mas-ka/everGPIB/docs/everGPIB_NanoV3Ethernetシールド_パターンカット説明図.pdf

A | B | C | D | E | F | G

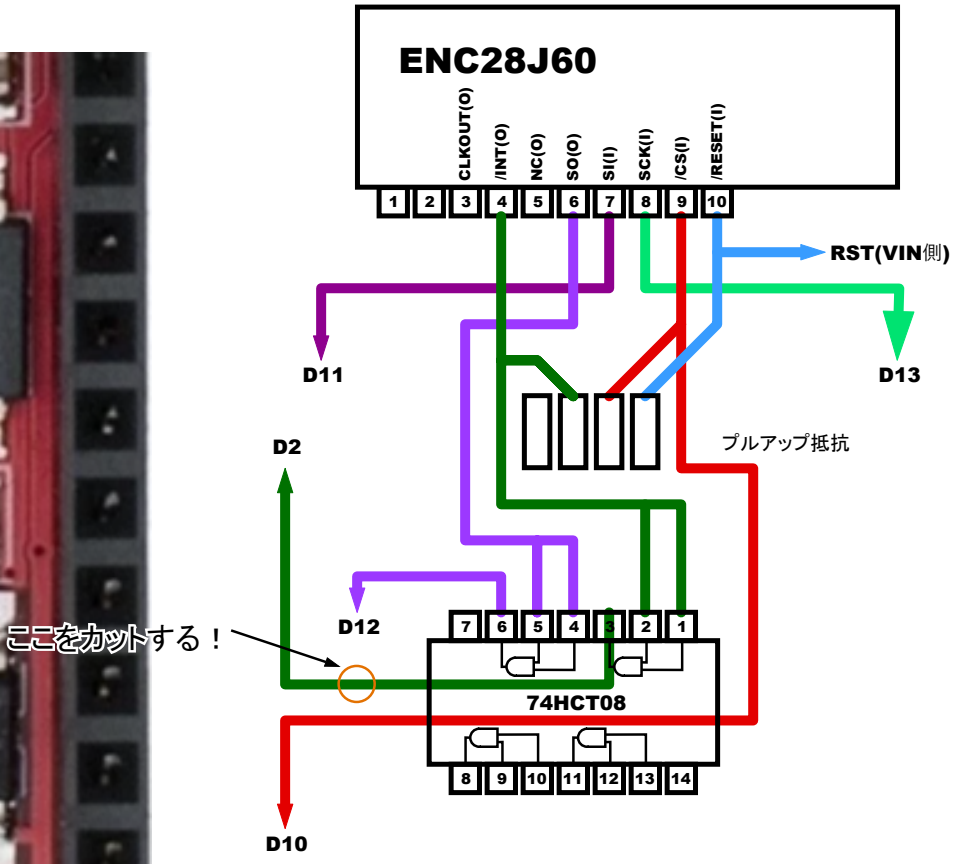
[picture p1: figure]
CLKOUT(O); /INT(O); SCK(I); /RESET(I); ENC28J60; プルアップ抵抗; 74HCT08; RST(VIN側); ここをカットする！
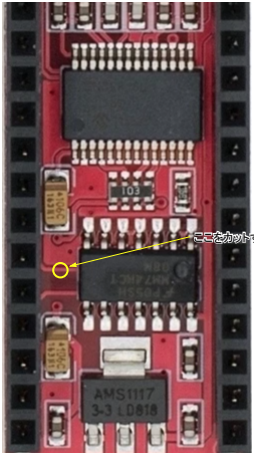
[picture p2: figure]

A | B | C | D | E | F | G

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
2022-10-07

mas-ka

everGPIB用
NanoV3イーサネットシールド
パターンカット 説明図

※ カット前に74HCT08の3ピンがD2と導通してることを確認せよ！

※ カット後に74HCT08の3ピンがD2と導通していないことを確認せよ！
