mas-ka/everGPIB/docs/everGPIB_結線図.pdf

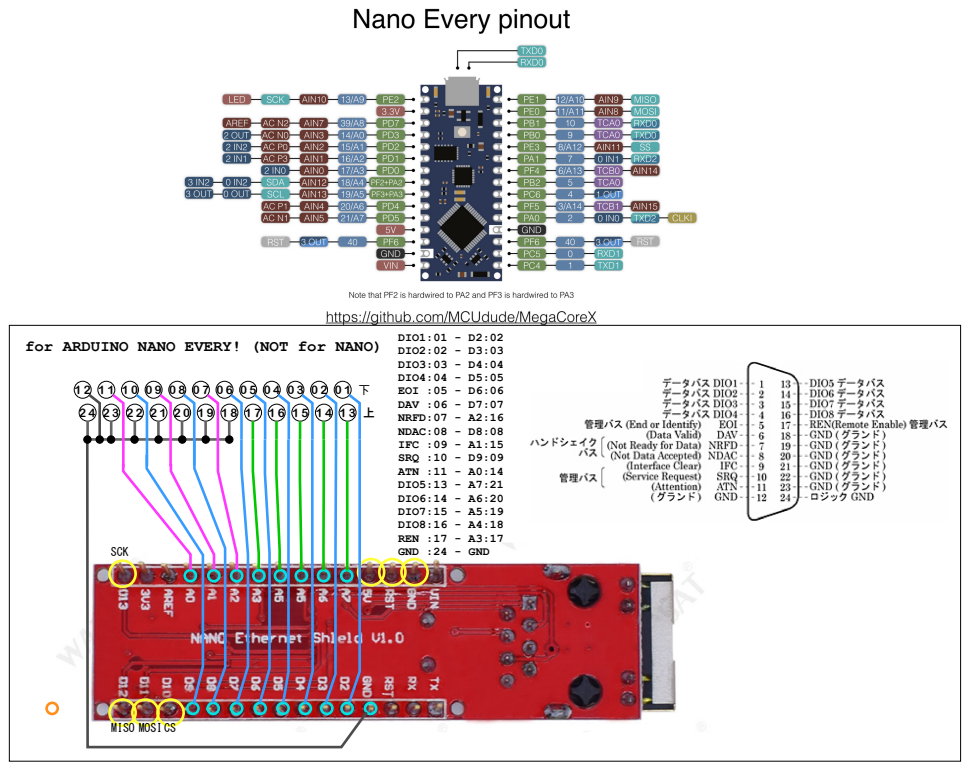
[picture p12: page 1]
SCK; DIO1:01 - D2:02 DIO2:02 - D3:03 DIO3:03 - D4:04 DIO4:04 - D5:05 EOI :05 - D6:06 DAV :06 - D7:07 NRFD:07 - A2:16 NDAC:08 - D8:08 IFC :09 - A1:15 SRQ :10 - D9:09 ATN :11 - A0:14 DIO5:13 - A7:21 DIO6:14 - A6:20 DIO7:15 - A5:19 DIO8:16 - A4:18 REN :17 - A3:17 GND :24 - GND

for ARDUINO NANO EVERY! (NOT for NANO)

MISO MOSI CS
