mas-ka/everGPIB/docs/everGPIB_電気回路図.pdf

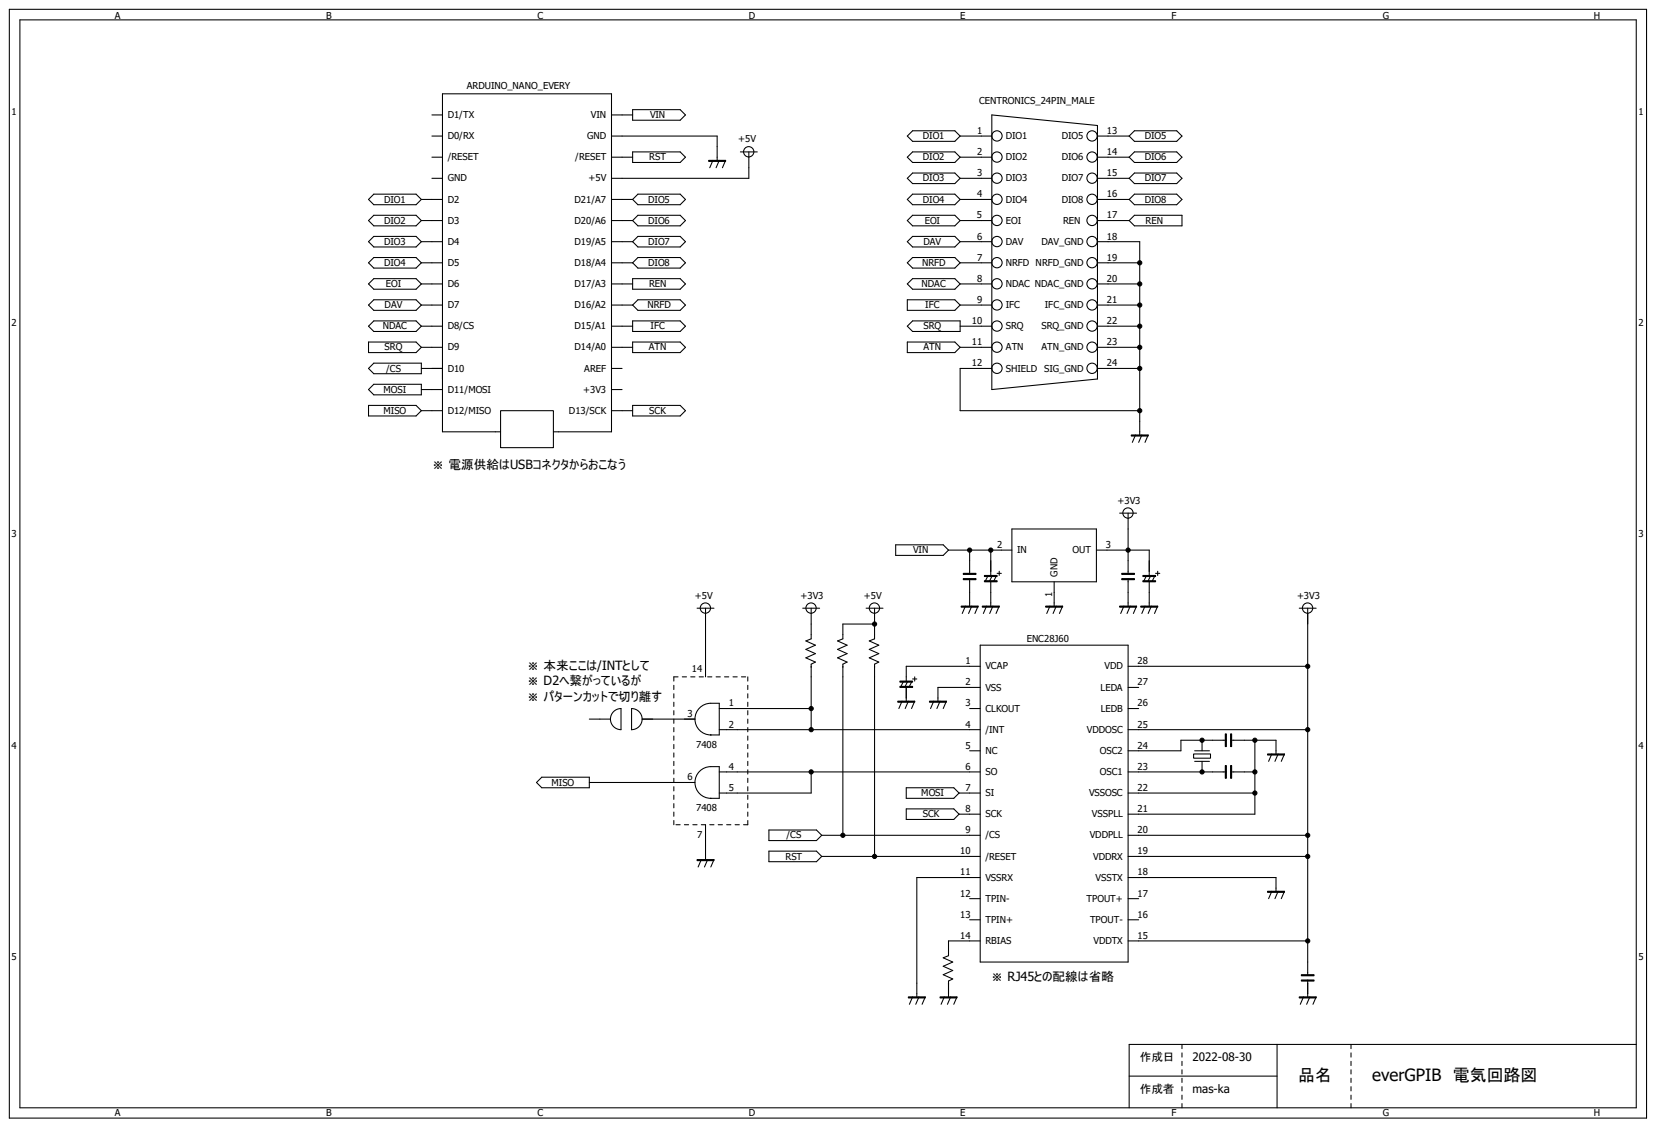
[picture p13: page 1]

作成日 | 2022-08-30

作成者 | mas-ka
