mas-ka/everGPIB/GPIB.h

/*
 * GPIB library for Arduino Nano Every (※ NOT for NANO)
 * NanoでSPI接続のEthernetモジュールと併用するにはピンが足りない！
 * NanoだとRENをGNDに落としてリモート専用にした上で
 * SRQをA6かA7のanalogRead()で対応する必要がある
 */
 
#ifndef _GPIB_
  #define _GPIB_
  #include "Arduino.h"
  
  // Define PIN assign
    #define DIO1  2
    #define DIO2  3
    #define DIO3  4
    #define DIO4  5
    #define DIO5  21
    #define DIO6  20
    #define DIO7  19
    #define DIO8  18
    #define EOI   6
    #define DAV   7
    #define NRFD  16
    #define NDAC  8
    #define IFC   15
    #define SRQ   9
    #define ATN   14
    #define REN   17
  
  class GPIB {
    public:
      boolean in_remote = false;
      unsigned long ms_timeout = 10000;    // ゼロならタイムアウトしない(デフォルトは10秒)
      byte target_address_default = 1;     // default target GPIB address
      String terminator_default = "13+10."; // default terminators
      boolean use_automatic_IFC = false,   // automatically IFC before TAL|LIS|CHA
              use_automatic_REN = false;   // automatically REN before TAL|LIS|CHA
      
      GPIB(); // インスタンス
      void init(void); // 初期化
      void sendIFC(void); // IFC
      void sendREM(void); // REM
      void sendLOC(void); // LOC
      boolean sendDCL(void); // DCL
      boolean sendSDC(const byte addr); // SDC
      boolean getSRQ(void); // SRQ
      boolean searchBySerialPoll(byte &addr, byte &status); // SRQのシリアルポール
      String getLineStatus(void); // ライン状態の取得
      boolean talk(const byte addr, const String com, const String del, const boolean eoi); // トーカ
      boolean listen(const byte addr, String &reply, const String del); // リスナ
      
    private:      
      byte get_dio(void);
      void set_dio(const byte x);
      boolean write(const byte data);
      boolean read(byte &data, boolean &eoi);
      
  };
#endif
