mas-ka/everGPIB/(commit log)

2022-08-24 大昔のコードをざっくりと移植して、コンパイルできるとこまで修正してみた。
2022-08-25 GPIBをクラス化してライブラリに分けてコンパイルが通るとこまで来た（※また実機で動かしてはいない）
2022-08-26 SerialPollを実装してみた（動作試験未実施）
2022-08-26 シリアル側のコマンドインタプリタを実装した（実機動作試験は未実施）。これでとりあえず完成したっぽいがNanoであと1200byteしか空いてないｗ
2022-08-26 自宅作業、IPアドレスのバグ修正
2022-08-26 Ethernet側コマンドでクライアントに「OK|ERROR」を返信するように変更した（残り1KB）。
2022-08-27 TALKにデリミタ送信を、クライアントからのシリアルポールを追加した。Nanoで残り300バイト。
2022-08-27 デフォルトターゲットアドレスとデフォルトデリミタの実装を削除し、必ずアドレスとデリミタを指定しなければならなく変更した。またデリミタなしを可能とし、EOIの有無も指定できるようにした。
2022-08-28 タイムアウトにゼロを与えた場合にはタイムアウトを監視しないよう修正した。
2022-08-29 Nano互換機で実機動作試験、シリアル側コマンドインタプリタ動作確認済み。
2022-08-29 W5500のEthernetモジュールを繋いでEthernet側コマンドインタプリタの動作確認（※一時的にEthernet.hに変えてある）。ACCEPTとかTIMとかはちゃんと動いた
2022-08-29 GPIB繋いで実機（428-PROG）動作試験、、、デバッグスタブ色々突っ込んでみたがズタボロｗ NanoEveryだとA6とA7はD20とD21にできるがNanoではそれができない、、、ピン足りないｗ
2022-08-29 debugプリント削除し、NanoEvery専用としてピンアサインを設定した（実機動作試験は未実施）。NanoEvery専用としたことでフラッシュに空きができたからシリアルコマンドを再度追加するかなあ？
2022-08-30 NanoEvery実機動作確認と修正、、、エラい苦労するがなんとか動くとこまで来た、、、がSPOした後のLISとかCONが戻ってこない不具合が残ってる。
2022-08-30 STAすると強制的にRENがLOWになってしまう不具合を修正（RENをdigitalReadせず記憶してる状態真偽値を返すようにした）。
2022-08-30 SPOした後にLISとかCONすると謎文字が無限に返ってくる不具合を修正（SPO内でRQSビットが見つかった後にATNとかSPDとかの後片付けをしてなかった）。
2022-08-30 コントローラのデフォルト（ターゲットGPIBアドレスとデリミタおよびEOIアサート）の設定を復活した。ポートをPrologixと見分けられるよう「2345」に変更した。428-PROGでの実機動作確認OK。
2022-08-30 名前を「everGPIB」に変更した。
2022-09-01 Ether側コマンド"CON"を"CHA"に変更。シリアル側コマンド"AIC","ARE"を追加。自動IFC機能と自動REN機能を追加。シリアル側コマンド"?|?HEL|HELP"を追加。実機動作確認OK。
2022-09-01 シリアル側コマンドのヘルプに例を付けて書式を若干変更した。
2022-09-02 DELimitorsをTERminatorsに変更、Ether側から接続された際にBUSY/ACCCEPTを返答しない、シリアル側からの!コマンドでMACとIPA以外を即時反映、Ether側のRSTコマンドを除去
2022-10-03 CA5351に対応させるため色々とデバッグ中、、、5351クセが強いというかバグがあるのでは？
2022-10-04 Revert "CA5351に対応させるため色々とデバッグ中、、、5351クセが強いというかバグがあるのでは？"
    This reverts commit 798ab06c6e08bd781a8f9f3b92bc3c386f4ce80c.
    [GPIB.cpp]
2022-10-04 GPIB::talk のEOIんとこをちょっとだけスマートにしてみた
2022-10-06 EtherENCで動くように修正した。Etherで繋がることは確認したがGPIBの動作までは確認できていない。
2022-10-18 IDE2.0に変更し、起動時のMACアドレス読み込みのバグを修正した。実機動作確認済み。
2022-10-18 取説の作成開始
2022-10-19 取説、だいたい書けた。作り方の解説も書くべきか？
2022-10-20 取説、製作上の注意も含めて全部書けた
2024-11-06 マニュアルをリポジトリから削除した（GoogleDrive側で管理する）。
2026-09-16 関連文書（取扱説明書、回路図、結線図、パターンカット説明図）をdocsフォルダに追加
2026-09-16 README.mdを追加
2026-09-16 docs内のファイルメタデータから個人名を削除
2026-09-16 ライセンス（CC BY-SA 4.0）を追加
